ruediste/diy-dc-converter/(list of files, drawings)

Other design files:
docs/pages/010_FirstConverter/_fritzing.fzz
