ruediste/diy-dc-converter/docs/pages/010_FirstConverter/_kicad/kicad.kicad_sch

## KiCad design docs/pages/010_FirstConverter/_kicad/kicad.kicad_sch (2023-03-04)

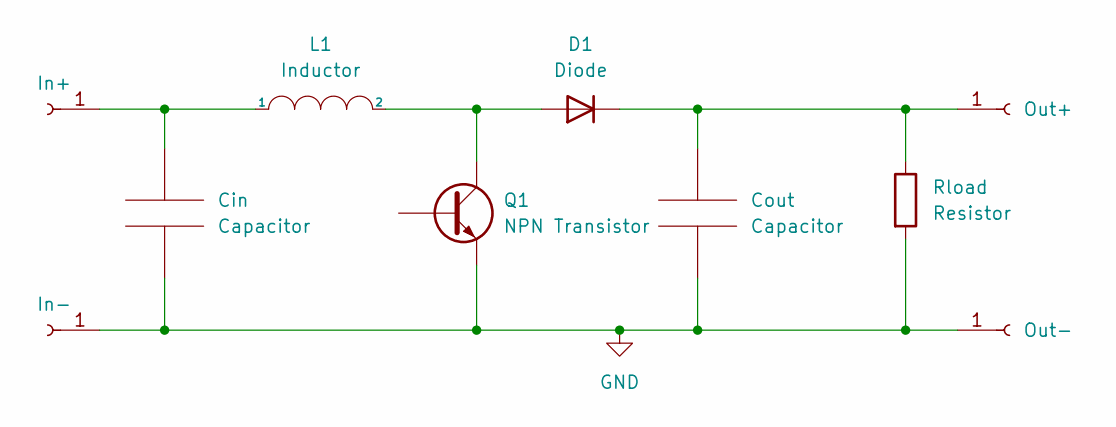
[picture p33: schematic kicad.kicad_sch]

Parts:
Cin: Capacitor
Cout: Capacitor
D1: Diode
In+: Conn_01x01_Female
In-: Conn_01x01_Female
L1: Inductor
Out+: Conn_01x01_Female
Out-: Conn_01x01_Female
Q1: NPN Transistor
Rload: Resistor

Connections:
unnamed: Cin.1, In+.1, L1.1
unnamed: Cin.2, Cout.2, In-.1, Out-.1, Q1.1 (E), Rload.2
unnamed: Cout.1, D1.2 (K), Out+.1, Rload.1
unnamed: D1.1 (A), L1.2, Q1.3 (C)
