ruediste/diy-dc-converter/docs/pages/020_SimpleControl/_kicad/simpleControl.kicad_sch

## KiCad design docs/pages/020_SimpleControl/_kicad/simpleControl.kicad_sch (2023-04-02)

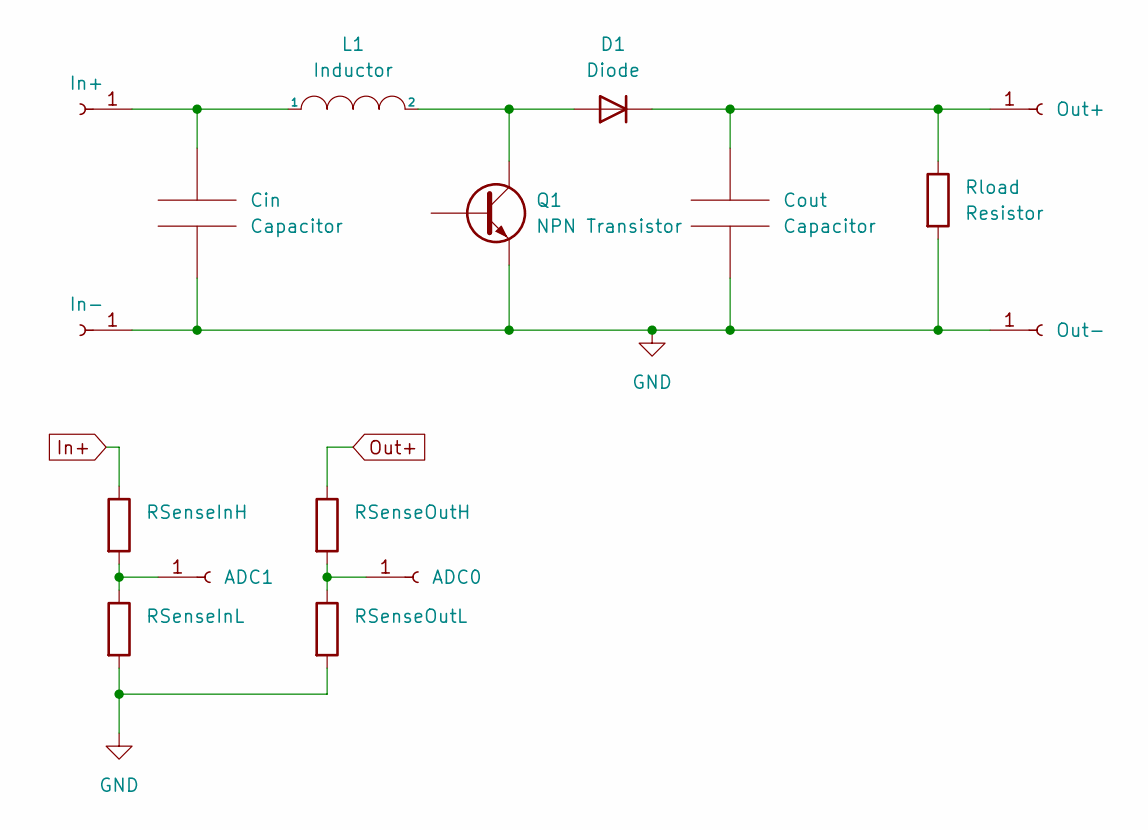
[picture p34: schematic simpleControl.kicad_sch]

Parts:
ADC0, ADC1: Conn_01x01_Female
Cin: Capacitor
Cout: Capacitor
D1: Diode
In+: Conn_01x01_Female
In-: Conn_01x01_Female
L1: Inductor
Out+: Conn_01x01_Female
Out-: Conn_01x01_Female
Q1: NPN Transistor
RSenseInH: Resistor
RSenseInL: Resistor
RSenseOutH: Resistor
RSenseOutL: Resistor
Rload: Resistor

Connections:
In+: RSenseInH.1
unnamed: ADC0.1, RSenseOutH.2, RSenseOutL.1
unnamed: ADC1.1, RSenseInH.2, RSenseInL.1
unnamed: Cin.1, In+.1, L1.1
unnamed: Cin.2, Cout.2, In-.1, Out-.1, Q1.1 (E), Rload.2
unnamed: Cout.1, D1.2 (K), Out+.1, Rload.1
unnamed: D1.1 (A), L1.2, Q1.3 (C)
unnamed: RSenseInL.2, RSenseOutL.2
Out+: RSenseOutH.1
