ruediste/diy-dc-converter/fw/src/fw.ioc

Mcu.UserName=STM32F401CDUx
PA0-WKUP.Signal=ADCx_IN0
PA1.Signal=ADCx_IN1
PA11.Signal=USB_OTG_FS_DM
PA12.Signal=USB_OTG_FS_DP
PA8.GPIO_Label=Switch Out (TIM1_CH1)
PA8.Signal=S_TIM1_CH1
PC14-OSC32_IN.Signal=RCC_OSC32_IN
PC15-OSC32_OUT.Signal=RCC_OSC32_OUT
