ruediste/diy-dc-converter/fw/src/Core/Src/main.c

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
/* Includes ------------------------------------------------------------------*/
#include "main.h"
#include "usb_device.h"

/* USER CODE BEGIN Includes */
#include "usbd_cdc_if.h"
#include "control_main.h"
/* USER CODE END Includes */

ADC_HandleTypeDef hadc1;
DMA_HandleTypeDef hdma_adc1;

TIM_HandleTypeDef htim1;
TIM_HandleTypeDef htim9;

void SystemClock_Config(void);
static void MX_GPIO_Init(void);
static void MX_DMA_Init(void);
static void MX_TIM1_Init(void);
static void MX_ADC1_Init(void);
static void MX_TIM9_Init(void);
/**
 * @brief  The application entry point.
 * @retval int
 */
int main(void)
{
  /* MCU Configuration--------------------------------------------------------*/

  /* Reset of all peripherals, Initializes the Flash interface and the Systick. */
  HAL_Init();

  /* Configure the system clock */
  SystemClock_Config();

  /* Initialize all configured peripherals */
  MX_GPIO_Init();
  MX_DMA_Init();
  MX_TIM1_Init();
  MX_USB_DEVICE_Init();
  MX_ADC1_Init();
  MX_TIM9_Init();
  /* USER CODE BEGIN 2 */

  // HAL_TIM_Base_Start(&htim1);
  // HAL_TIM_PWM_Start(&htim1, TIM_CHANNEL_1);

  // TIM1->DIER |= TIM_IT_UPDATE;
  /* USER CODE END 2 */

  /* Infinite loop */
  /* USER CODE BEGIN WHILE */
  while (1)
  {
    /* USER CODE END WHILE */

    /* USER CODE BEGIN 3 */
    // uint8_t HiMsg[] = "hello\r\n";
    // CDC_Transmit_FS(HiMsg, strlen((char *)HiMsg));
    // TIM1->CCR1 += 5000;
    // HAL_Delay(2000);
    controlMain();
  }
  /* USER CODE END 3 */
}

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
