ruediste/diy-dc-converter/control/src/main/java/com/github/ruediste/App.java

package com.github.ruediste;

import java.awt.GridLayout;
import java.io.ByteArrayOutputStream;
import java.io.IOException;
import java.io.Serializable;
import java.nio.ByteBuffer;
import java.nio.ByteOrder;
import java.nio.file.Path;
import java.util.ArrayList;
import java.util.Comparator;
import java.util.List;

import javax.inject.Inject;
import javax.swing.*;

import org.mapdb.DB;
import org.mapdb.DBMaker;
import org.slf4j.Logger;
import org.slf4j.LoggerFactory;

import com.github.ruediste.mode.Mode;
import com.github.ruediste.mode.Mode.ModeInstance;
import com.github.ruediste.serial.AvailableDevicesAppController;
import com.github.ruediste.serial.RealSerialConnection;
import com.google.inject.AbstractModule;
import com.google.inject.Guice;
import com.google.inject.Injector;
import com.google.inject.Provides;

import io.github.classgraph.ClassGraph;
import io.github.classgraph.ScanResult;

/**
 * Hello world!
 *
 */
public class App {

    private final Logger log = LoggerFactory.getLogger(App.class);

    @Inject
    UiRefresh refresh;

    @Inject
    AvailableDevicesAppController availableDevicesAppController;

    @Inject
    Injector injector;

    @Inject
    Persistence persistence;

    @Inject
    InterfaceSerializer interfaceSerializer;

    private List<Mode<?>> modes = new ArrayList<>();

    JPanel modeContainer;
    JCheckBox autoSend;
    JLabel[] debugLabels = new JLabel[4];
    JLabel systemStatusLabel = new JLabel();

    private class ModeInstanceController<TSettings extends Serializable> {
        ModeInstance<TSettings> instance;
        TSettings settings;

        @SuppressWarnings("unchecked")
        ModeInstanceController(Mode<TSettings> mode) {
            try {
                settings = (TSettings) persistence.settings.get(mode.name);
            } catch (Exception e) {
                log.error("Unable to load settings for " + mode.name, e);
                persistence.settings.clear();
                persistence.commit();
            }
            if (settings == null)
                settings = mode.createDefaultSettings();

            persistence.currentMode.set(mode.name);
            persistence.commit();
            instance = mode.createInstance();
            modeContainer.removeAll();
            modeContainer.add(instance.initialize(settings, () -> {
                persistence.settings.put(mode.name, settings);
                persistence.commit();
                if (autoSend.isSelected()) {
                    sendConfigMessage();
                }
            }));
            modeContainer.revalidate();
            modeContainer.repaint();
        }

        public void sendConfigMessage() {
            var msg = instance.toConfigMessage(settings);
            System.out.println("Send " + msg);
            sendMessage(msg);
        }

        public void handle(Object msg) {
            instance.handle(msg, settings);
        }
    }

    RealSerialConnection con;
    LoopingThread readLoop;
    ModeInstanceController<?> modeInstanceController;

    List<Path> serialConnections;
    Path serialConnectionPath;

    private void closeSerialConnection() {
        if (con == null)
            return;

        try {
            con.close();
        } catch (Exception e1) {
            // swallow
        }
        readLoop.stop();
        con = null;
    }

    public void sendMessage(InterfaceMessage msg) {
        openSerialConnection();
        var baos = new ByteArrayOutputStream();
        interfaceSerializer.serialize(msg, baos);
        try {
            con.sendBytes(baos.toByteArray());
        } catch (Exception e) {
            closeSerialConnection();
            openSerialConnection();
            con.sendBytes(baos.toByteArray());
        }
    }

    private void openSerialConnection() {
        if (con != null)
            return;
        con = new RealSerialConnection(serialConnectionPath.toString(), 115000);
        var in = con.getIn();
        readLoop = new LoopingThread("Read Loop", () -> {
            var msg = interfaceSerializer.deserialize(in);
            SwingUtilities.invokeLater(() -> {
                if (msg instanceof DebugMessage dbg) {
                    for (int i = 0; i < debugLabels.length; i++) {
                        debugLabels[i].setText(RealSerialConnection.hexDump(dbg.data, i * 4, 4) + " asFloat: "
                                + ByteBuffer.wrap(dbg.data, i * 4, 4).order(ByteOrder.LITTLE_ENDIAN).getFloat());
                    }
                } else if (msg instanceof SystemStatusMessage status) {
                    systemStatusLabel.setText("ADC0: " + status.adcValues[0] + " ADC1: " + status.adcValues[1]
                            + "CPU: %.2f%%".formatted(status.controlCpuUsageFraction * 100));

                } else
                    modeInstanceController.handle(msg);
            });
        }, in::close);
    }

    private void createAndShowGUI() {
        // Create and set up the window.
        JFrame frame = new JFrame("FW Controller");
        frame.setDefaultCloseOperation(JFrame.EXIT_ON_CLOSE);
        JPanel mainPanel = new JPanel();
        mainPanel.setLayout(new BoxLayout(mainPanel, BoxLayout.PAGE_AXIS));
        frame.setContentPane(mainPanel);
        JComboBox<String> modeComboBox;
        {
            JPanel topPanel = new JPanel();
            // topPanel.setLayout(new FlowLayout(topPanel, BoxLayout.LINE_AXIS));
            mainPanel.add(topPanel);

            // mode
            modeComboBox = new JComboBox<String>(modes.stream().map(x -> x.name).toArray(l -> new String[l]));
            modeComboBox.setMaximumSize(modeComboBox.getPreferredSize());
            topPanel.add(modeComboBox);
            modeComboBox.addActionListener(e -> showMode(modes.get(modeComboBox.getSelectedIndex())));

            // config send control
            autoSend = new JCheckBox("Auto Send");
            autoSend.setSelected(persistence.autoSend.get() == Boolean.TRUE);
            autoSend.addActionListener(e -> {
                persistence.autoSend.set(autoSend.isSelected());
                persistence.commit();
                if (autoSend.isSelected())
                    modeInstanceController.sendConfigMessage();
            });
            topPanel.add(autoSend);

            JButton send = new JButton("Send");
            send.addActionListener(e -> modeInstanceController.sendConfigMessage());
            topPanel.add(send);

            // serial connections
            serialConnections = availableDevicesAppController.getCurrentSerialConnections().stream()
                    .sorted(Comparator.comparing(x -> x.toString())).toList();
            serialConnectionPath = serialConnections.stream().findFirst().orElse(null);
            var connectionsComboBox = new JComboBox<String>(
                    serialConnections.stream().map(x -> x.toString()).toArray(l -> new String[l]));

            topPanel.add(connectionsComboBox);
            connectionsComboBox.addActionListener(e -> {
                con = null;
                serialConnectionPath = serialConnections.get(connectionsComboBox.getSelectedIndex());
            });
            availableDevicesAppController.onChange.add(() -> SwingUtilities.invokeLater(() -> {
                serialConnections = availableDevicesAppController.getCurrentSerialConnections().stream()
                        .sorted(Comparator.comparing(x -> x.toString())).toList();
                connectionsComboBox.setModel(new DefaultComboBoxModel<>(
                        serialConnections.stream().map(x -> x.toString()).toArray(l -> new String[l])));
            }));

            // trigger blob
            JButton triggerBlob = new JButton("Trigger Blob");
            triggerBlob.addActionListener(e -> sendMessage(new TriggerBlobMessage()));
            topPanel.add(triggerBlob);
        }

        // mode ui
        modeContainer = new JPanel();
        mainPanel.add(modeContainer);

        // load mode
        {
            var modeName = persistence.currentMode.get();
            int index = 0;
            if (modeName != null) {
                for (int i = 0; i < modes.size(); i++) {
                    if (modes.get(i).name.equals(modeName)) {
                        index = i;
                    }
                }
            }
            modeComboBox.setSelectedIndex(index);
            showMode(modes.get(index));
        }

        // debug labels
        {
            JPanel debugContainer = new JPanel(new GridLayout(debugLabels.length, 2));
            for (int i = 0; i < debugLabels.length; i++) {
                debugContainer.add(new JLabel("Debug " + i));
                debugLabels[i] = new JLabel();
                debugContainer.add(debugLabels[i]);
            }
            JPanel wrapper = new JPanel();
            wrapper.add(debugContainer);
            mainPanel.add(debugContainer);
        }

        mainPanel.add(systemStatusLabel);

        // Display the window.
        frame.pack();
        frame.setVisible(true);
    }

    public <T extends Serializable> void showMode(Mode<T> mode) {
        this.modeInstanceController = new ModeInstanceController<>(mode);
    }

    public static void main(String[] args) throws IOException {
        var injector = Guice.createInjector(new AbstractModule() {
            @Provides
            public DB provideMapDb() {
                return DBMaker.fileDB("control.db").transactionEnable().make();
            }

        });
        injector.getInstance(App.class).start();

    }

    public void start() throws IOException {
        persistence.initialize();
        availableDevicesAppController.start();

        // scan available modes
        try (ScanResult scanResult = new ClassGraph().enableAllInfo().acceptPackages(Mode.class.getPackageName())
                .scan()) {
            for (var modeInfo : scanResult.getSubclasses(Mode.class)) {
                if (modeInfo.isAbstract())
                    continue;
                modes.add((Mode<?>) injector.getInstance(modeInfo.loadClass()));
            }
            modes.sort(Comparator.comparing(x -> x.name));
        }

        // Schedule a job for the event-dispatching thread:
        // creating and showing this application's GUI.
        javax.swing.SwingUtilities.invokeLater(new Runnable() {
            public void run() {
                createAndShowGUI();
            }
        });
    }
}
