ruediste/diy-dc-converter/fw/src/circularBuffer.h

#ifndef CIRCULAR_BUFFER_H
#define CIRCULAR_BUFFER_H

#include <stdint.h>
#include <cstddef>

class CircularBuffer
{
public:
    CircularBuffer(size_t capacity);
    ~CircularBuffer();

    size_t size() const { return size_; }
    size_t capacity() const { return capacity_; }
    // Return number of bytes written.
    size_t write(const char *data, size_t bytes);
    // Return number of bytes read.
    size_t read(char *data, size_t bytes);

private:
    size_t beg_index_, end_index_, size_, capacity_;
    char *data_;
};

#endif
