ruediste/diy-dc-converter/(commit log)

2023-03-02 get interrupt working
2023-03-04 work on first converter
    [kicad.kicad_pcb, kicad.kicad_sch]
2023-03-05 add jekyll
    [kicad.kicad_pcb, kicad.kicad_sch]
2023-03-23 finish first converter
    [_fritzing.fzz, fritzing.fzz]
2023-03-27 work on DMA
2023-03-31 get ADC/DMA working
2023-04-02 start simple control page, add AdcCalculator tool
    [simpleControl.kicad_sch]
2023-04-15 switch to XChart
2023-04-17 switch to just-the-docs template
2023-04-18 work on PID
